jimwu6/Nocturne/RSGS/media/X 0.png

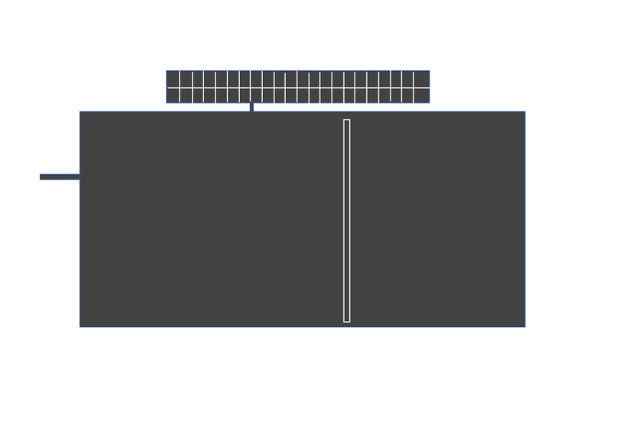
RSGS/media/X 0.png
