jimwu6/Nocturne/RSGS/media/X 5.png

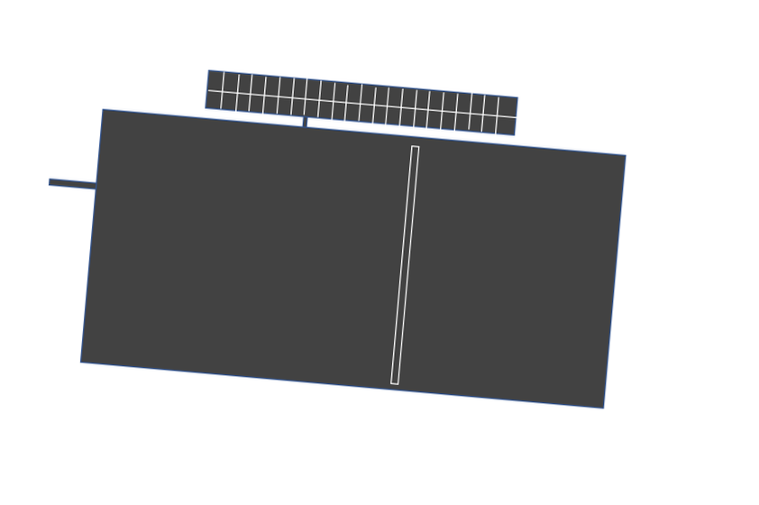
RSGS/media/X 5.png
