jimwu6/Nocturne/RSGS/media/X 20.png

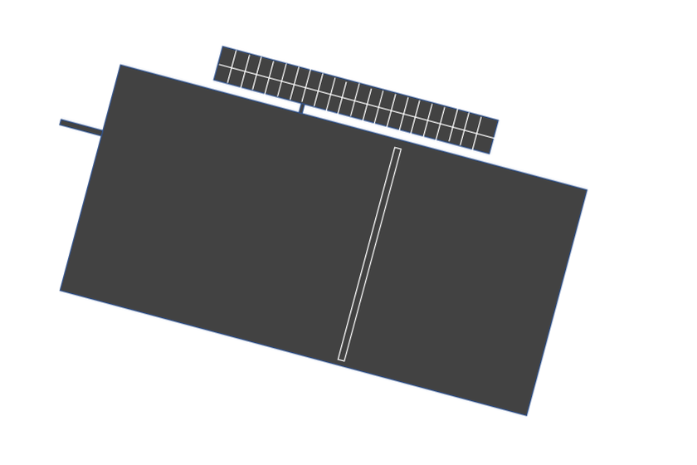
RSGS/media/X 20.png
