jimwu6/Nocturne/RSGS/media/X 25.png

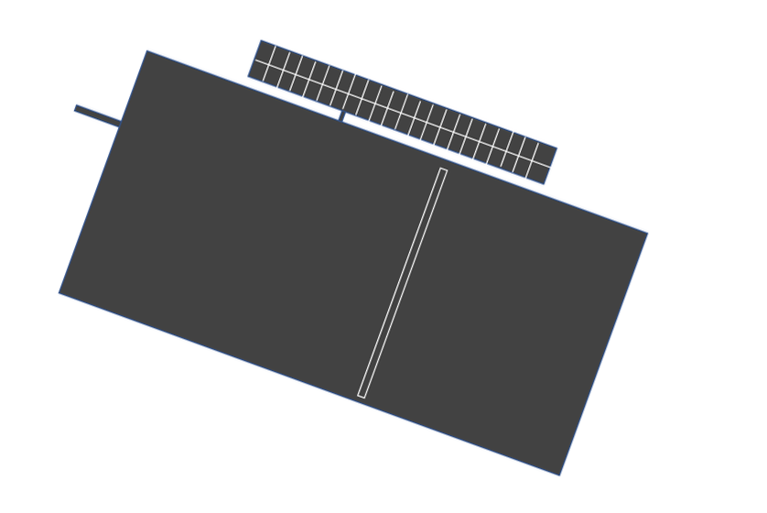
RSGS/media/X 25.png
