jimwu6/Nocturne/RSGS/media/X 35.png

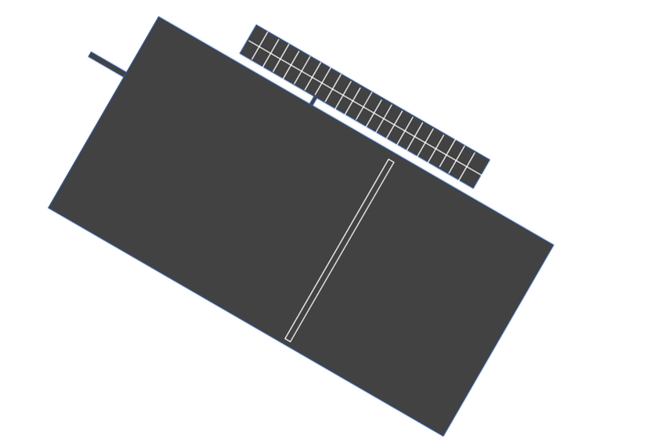
RSGS/media/X 35.png
