jimwu6/Nocturne/RSGS/media/X 50.png

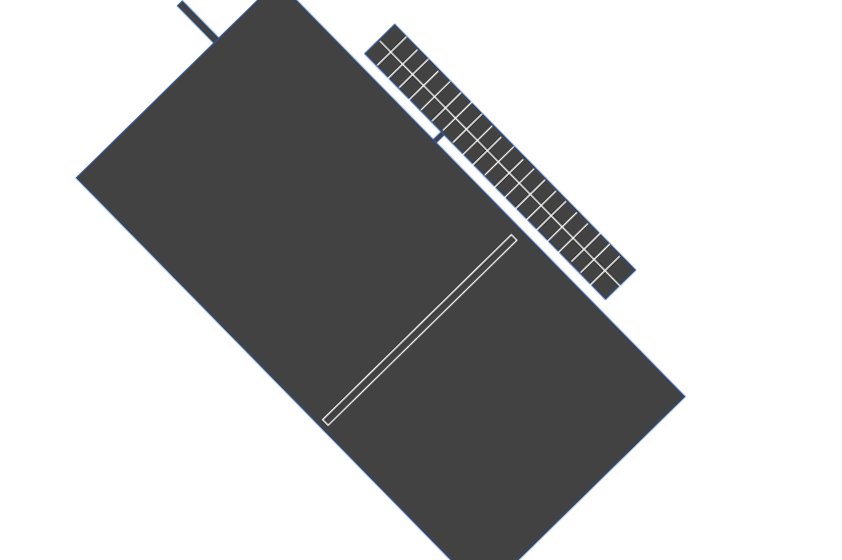
RSGS/media/X 50.png
