jimwu6/Nocturne/RSGS/media/X 60.png

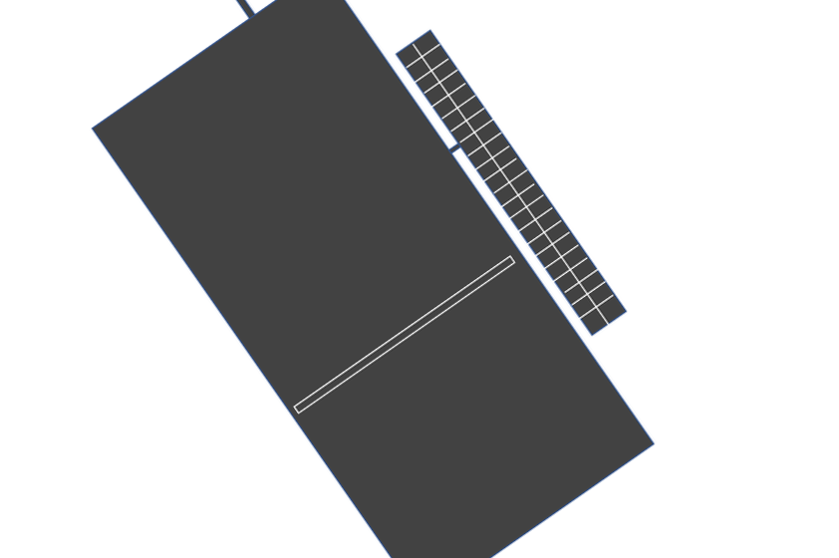
RSGS/media/X 60.png
