jimwu6/Nocturne/RSGS/media/X 80.png

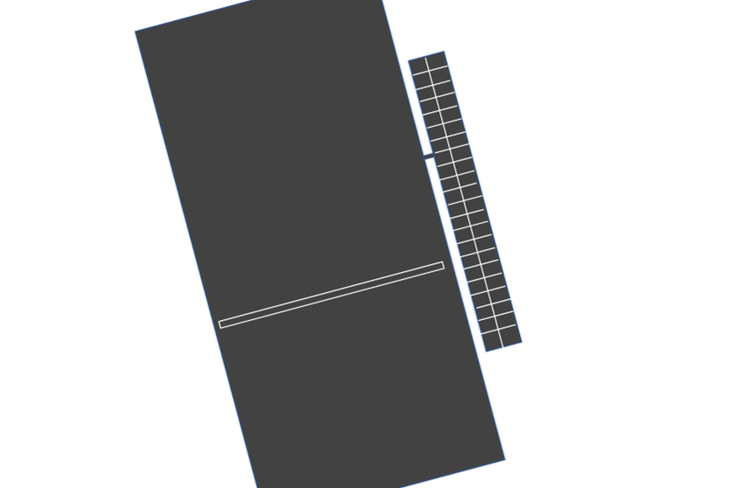
RSGS/media/X 80.png
