jimwu6/Nocturne/RSGS/media/X 85.png

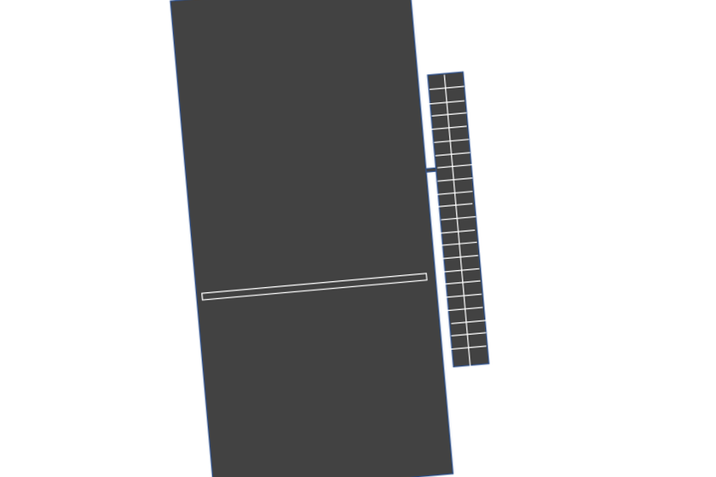
RSGS/media/X 85.png
