jimwu6/Nocturne/RSGS/media/X 95.png

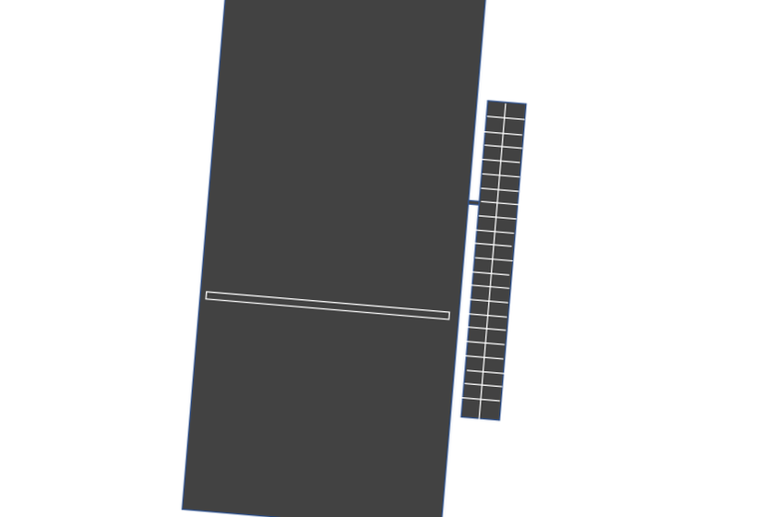
RSGS/media/X 95.png
