jimwu6/Nocturne/RSGS/media/X 105.png

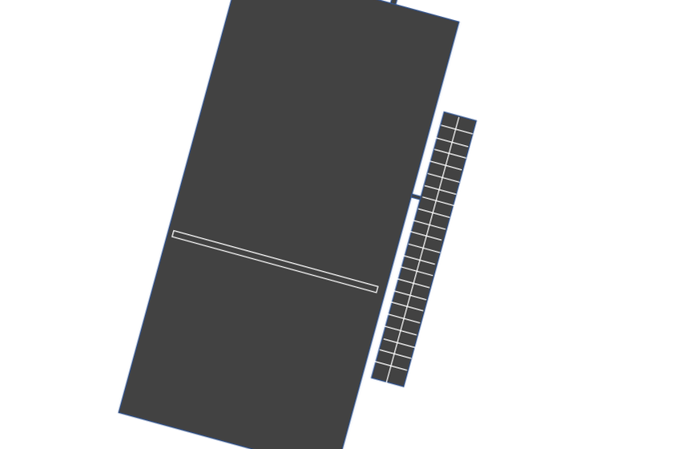
RSGS/media/X 105.png
