jimwu6/Nocturne/RSGS/media/X 110.png

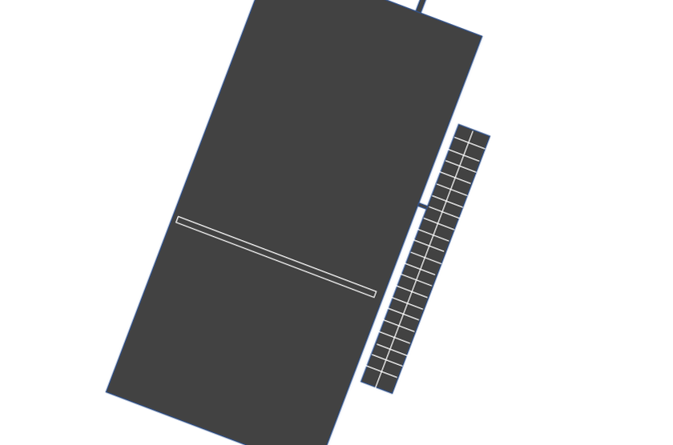
RSGS/media/X 110.png
