jimwu6/Nocturne/RSGS/media/X 130.png

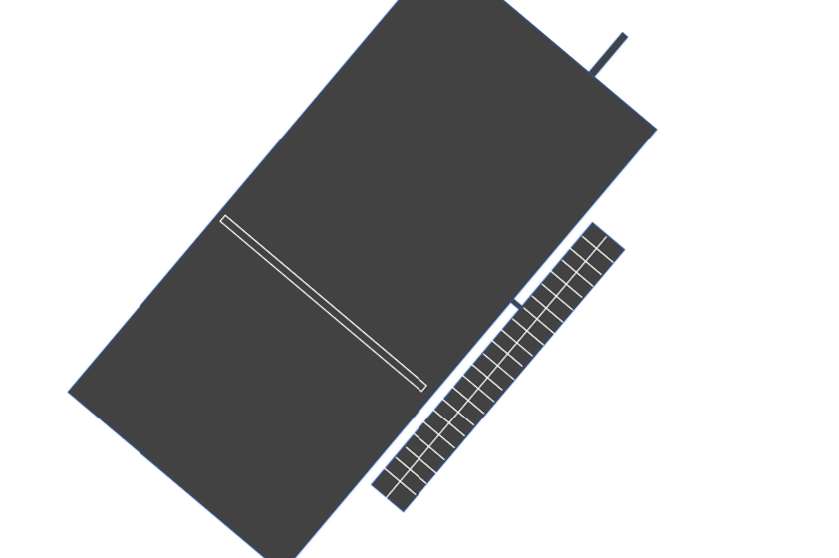
RSGS/media/X 130.png
