jimwu6/Nocturne/RSGS/media/X 140.png

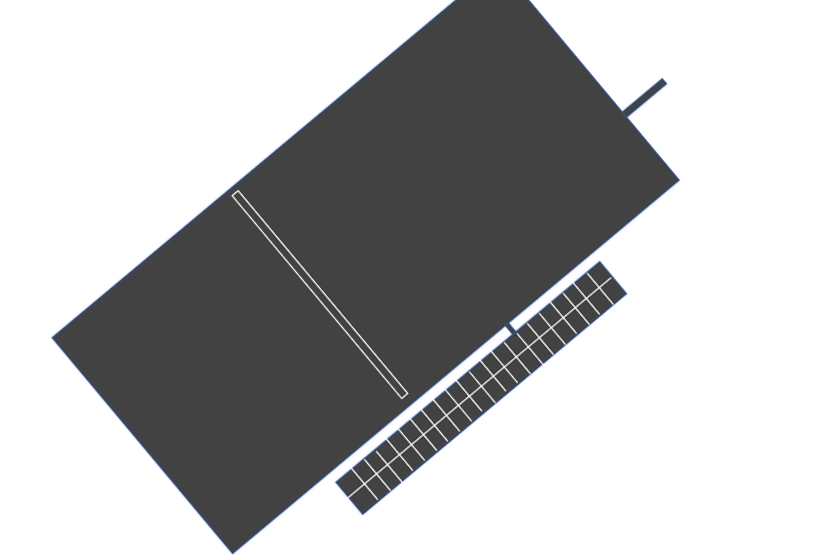
RSGS/media/X 140.png
