jimwu6/Nocturne/RSGS/media/X 145.png

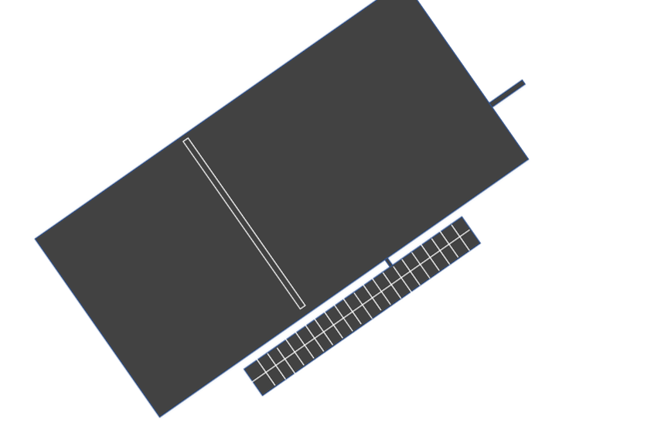
RSGS/media/X 145.png
