jimwu6/Nocturne/RSGS/media/X 155.png

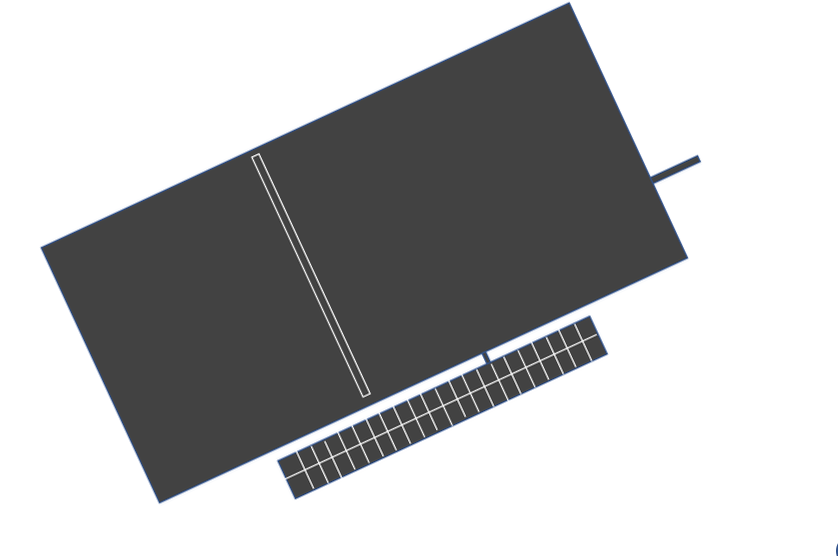
RSGS/media/X 155.png
