jimwu6/Nocturne/RSGS/media/X 160.png

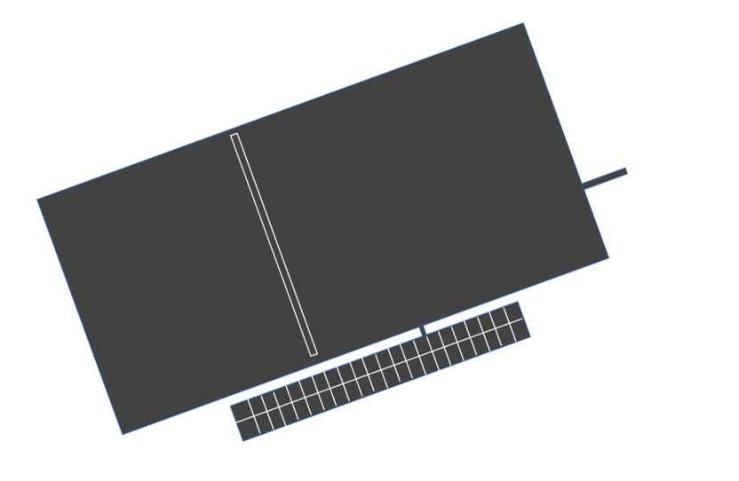
RSGS/media/X 160.png
