jimwu6/Nocturne/RSGS/media/X 170.png

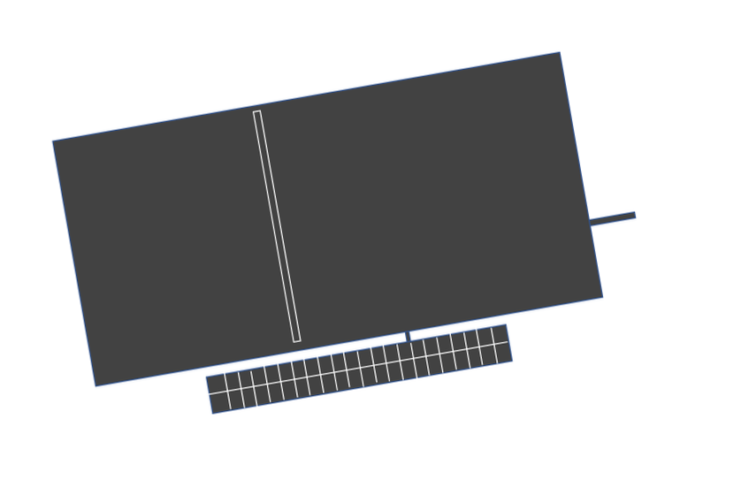
RSGS/media/X 170.png
