jimwu6/Nocturne/RSGS/media/X 175.png

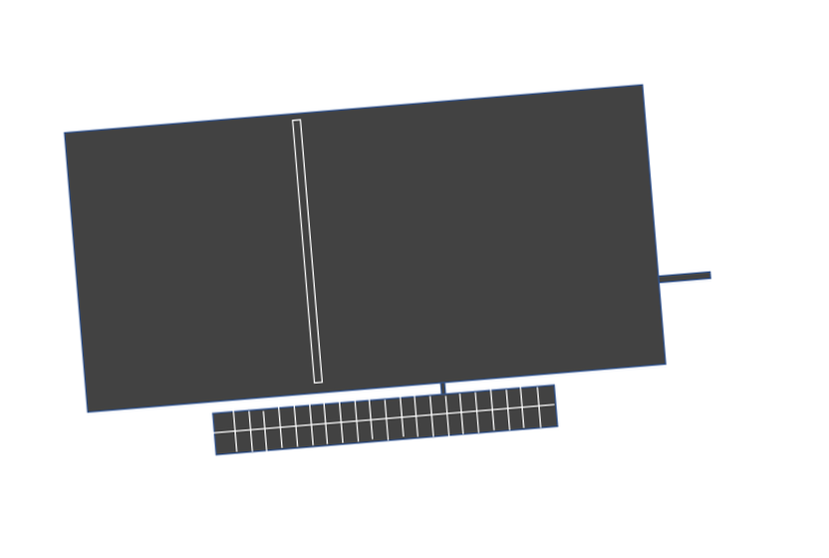
RSGS/media/X 175.png
