jimwu6/Nocturne/RSGS/media/X 180.png

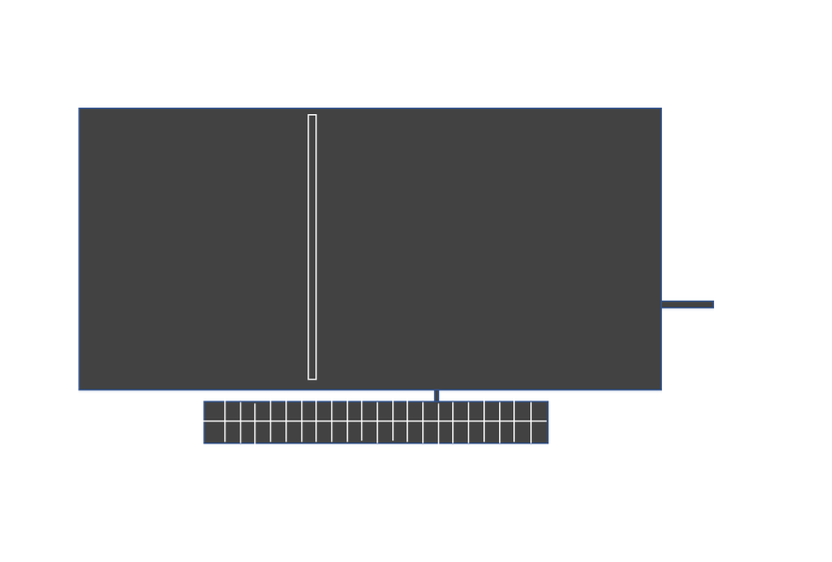
RSGS/media/X 180.png
