jimwu6/Nocturne/RSGS/media/X 185.png

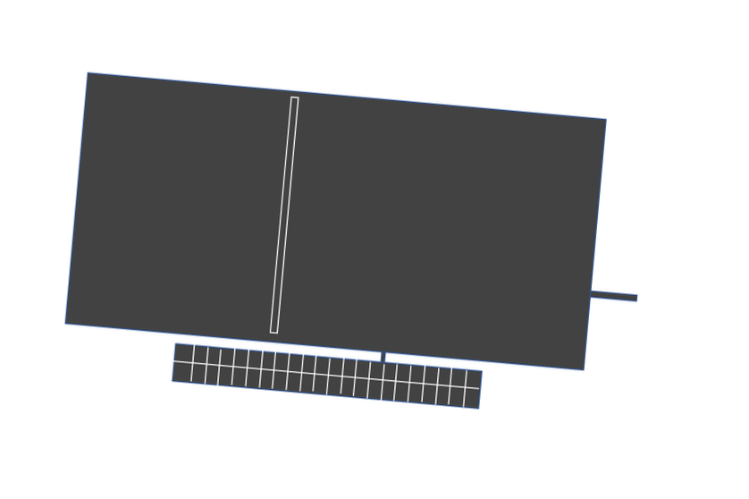
RSGS/media/X 185.png
