jimwu6/Nocturne/RSGS/media/X 190.png

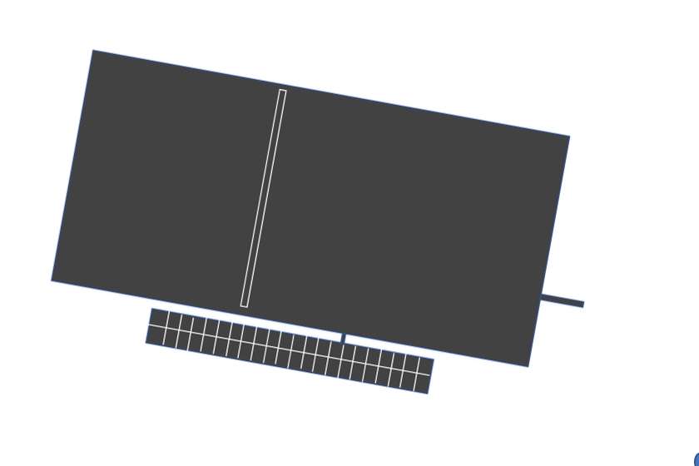
RSGS/media/X 190.png
