jimwu6/Nocturne/RSGS/media/X 195.png

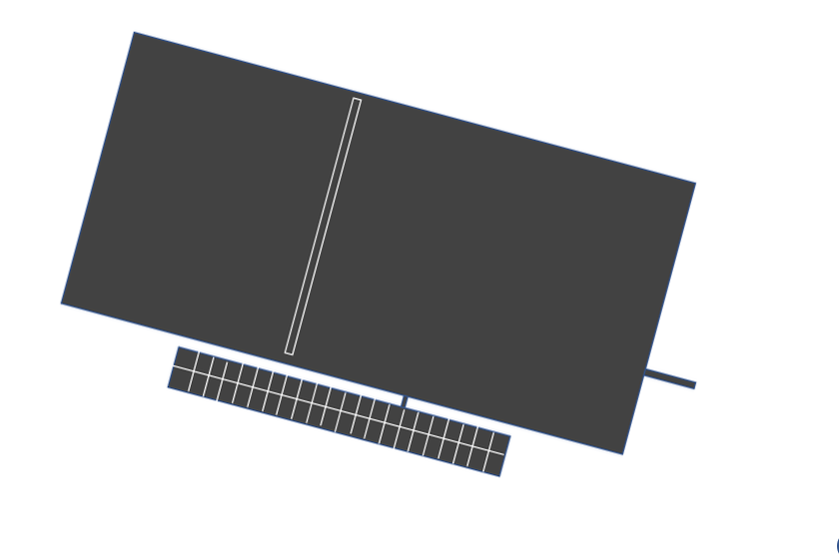
RSGS/media/X 195.png
