jimwu6/Nocturne/RSGS/media/X 205.png

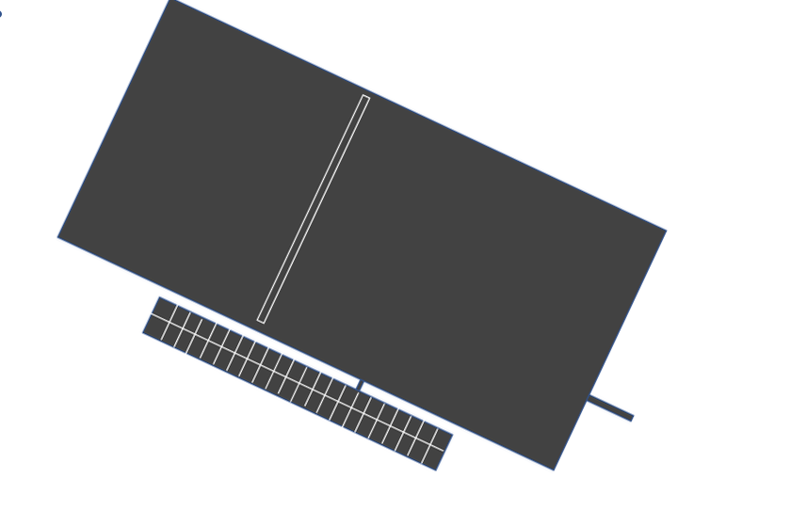
RSGS/media/X 205.png
