jimwu6/Nocturne/RSGS/media/X 215.png

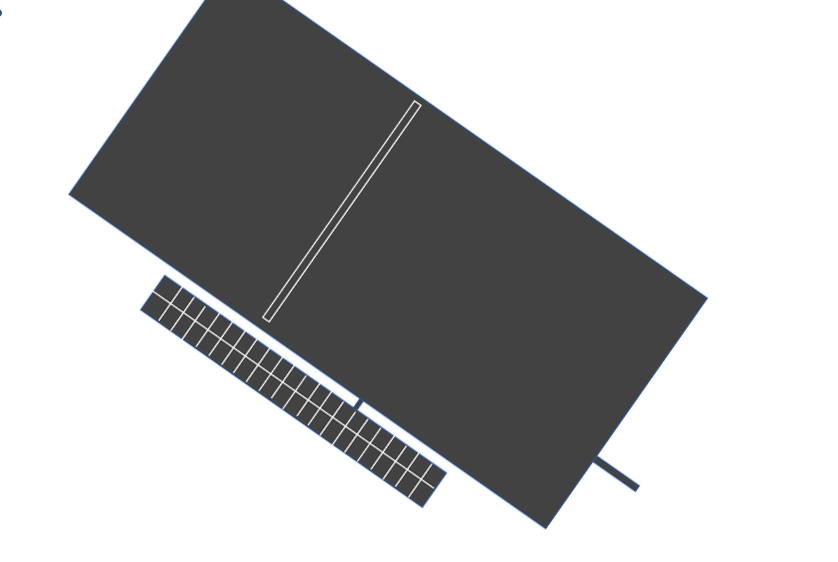
RSGS/media/X 215.png
