jimwu6/Nocturne/RSGS/media/X 220.png

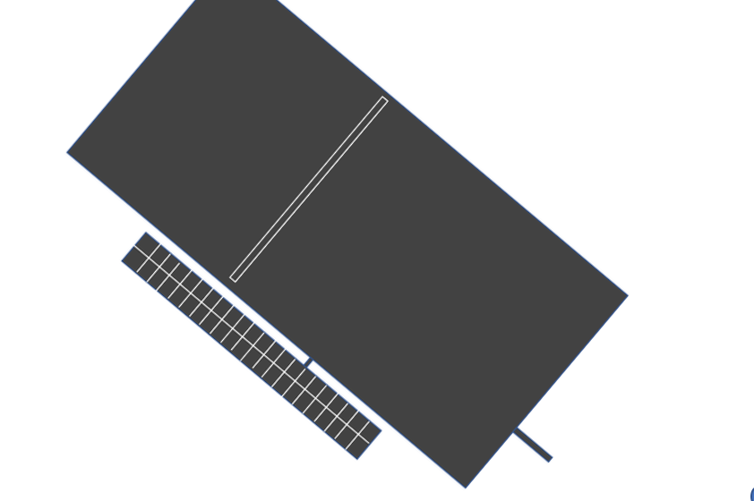
RSGS/media/X 220.png
