jimwu6/Nocturne/RSGS/media/X 235.png

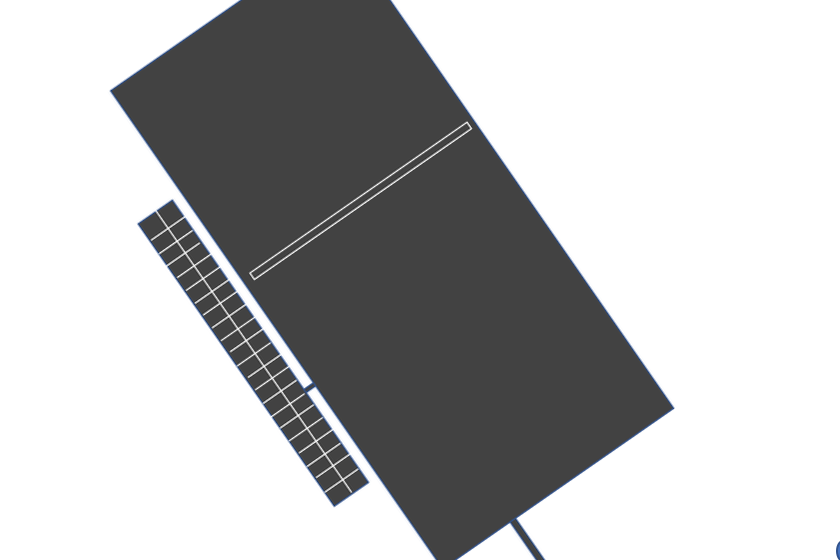
RSGS/media/X 235.png
