jimwu6/Nocturne/RSGS/media/X 250.png

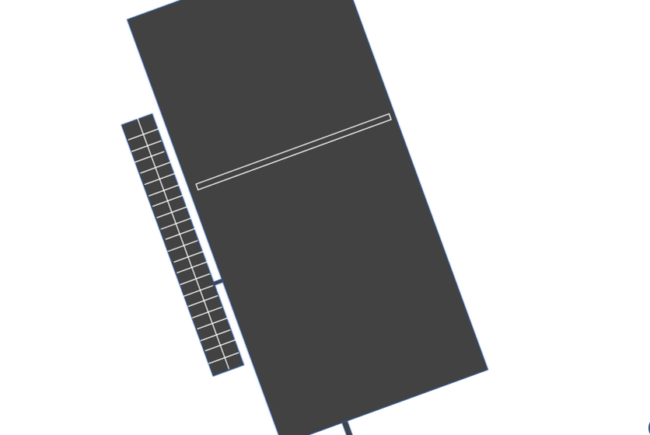
RSGS/media/X 250.png
