jimwu6/Nocturne/RSGS/media/X 265.png

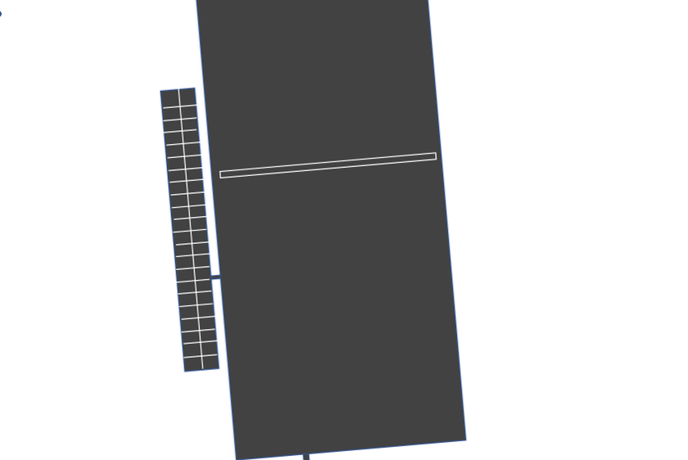
RSGS/media/X 265.png
