jimwu6/Nocturne/RSGS/media/X 270.png

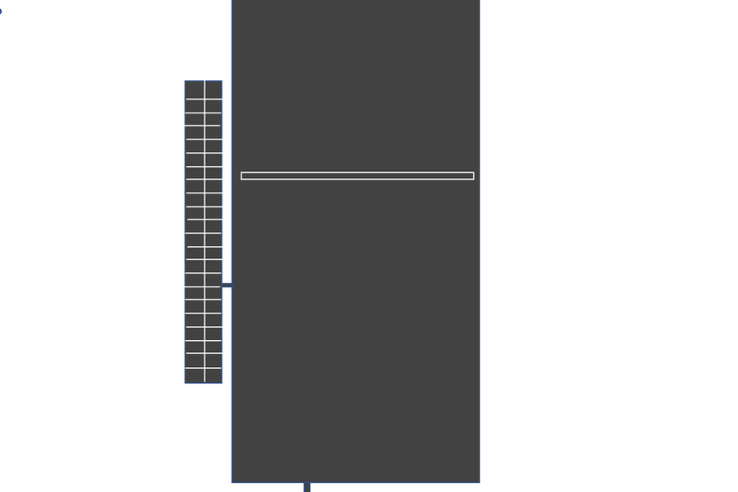
RSGS/media/X 270.png
