jimwu6/Nocturne/RSGS/media/X 275.png

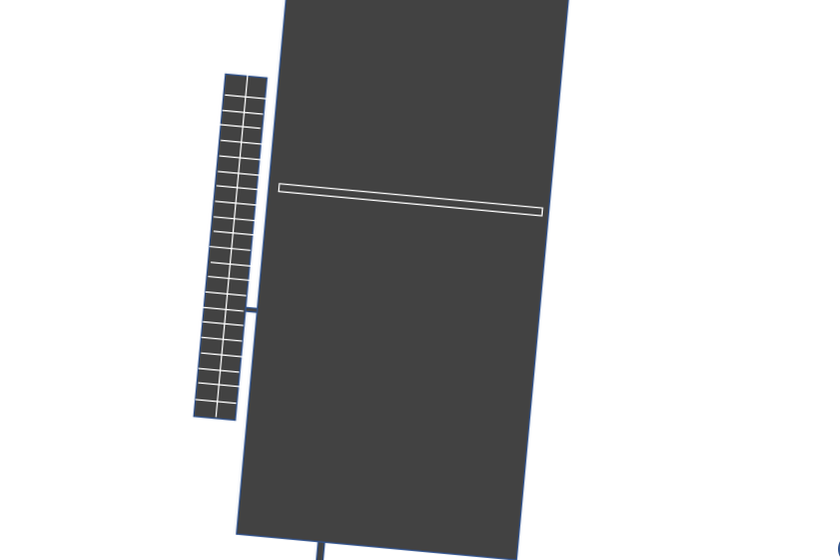
RSGS/media/X 275.png
