jimwu6/Nocturne/RSGS/media/X 280.png

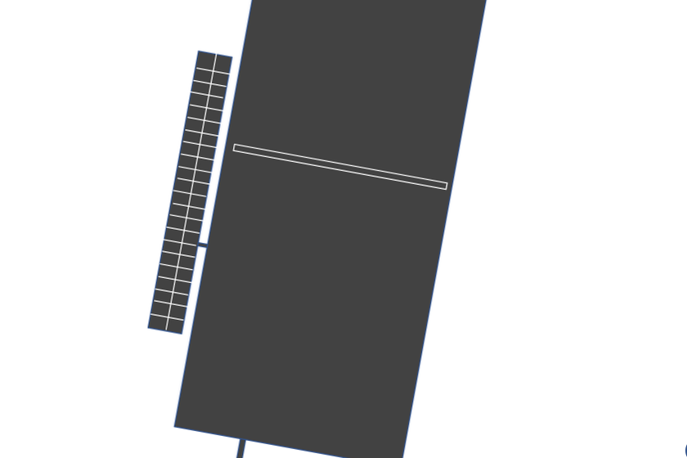
RSGS/media/X 280.png
