jimwu6/Nocturne/RSGS/media/X 295.png

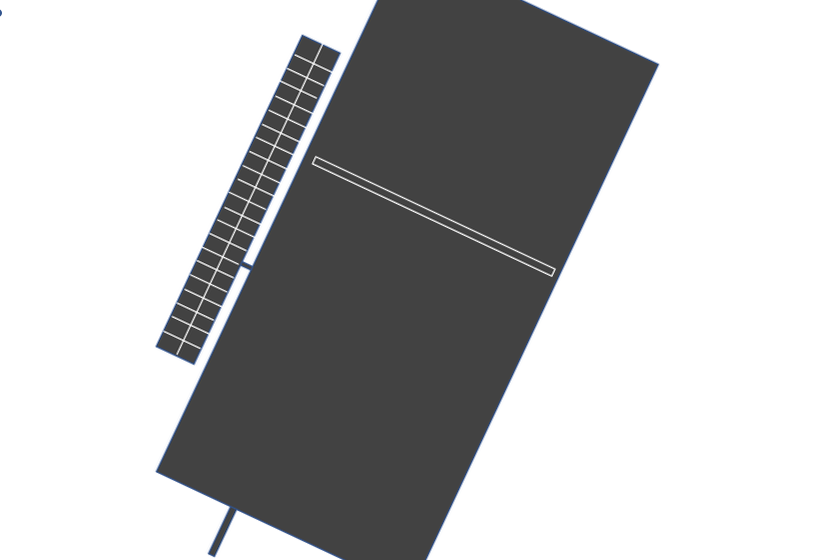
RSGS/media/X 295.png
