jimwu6/Nocturne/RSGS/media/X 300.png

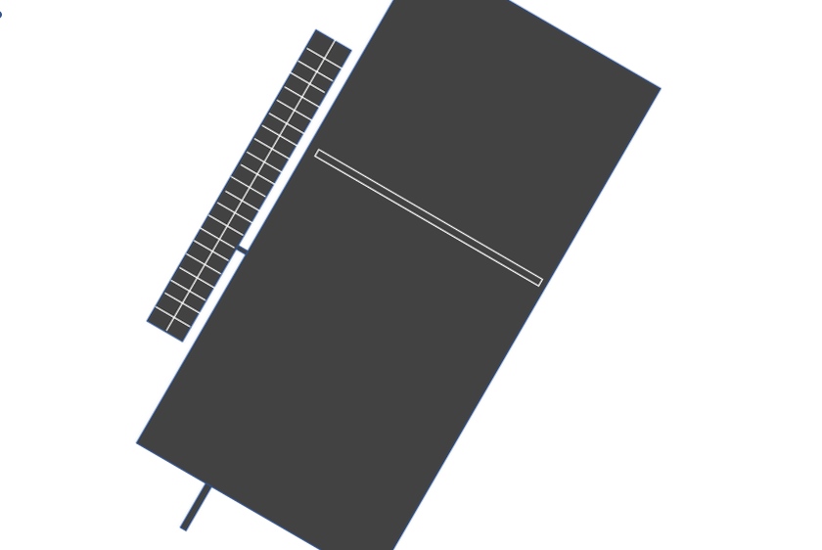
RSGS/media/X 300.png
