jimwu6/Nocturne/RSGS/media/X 315.png

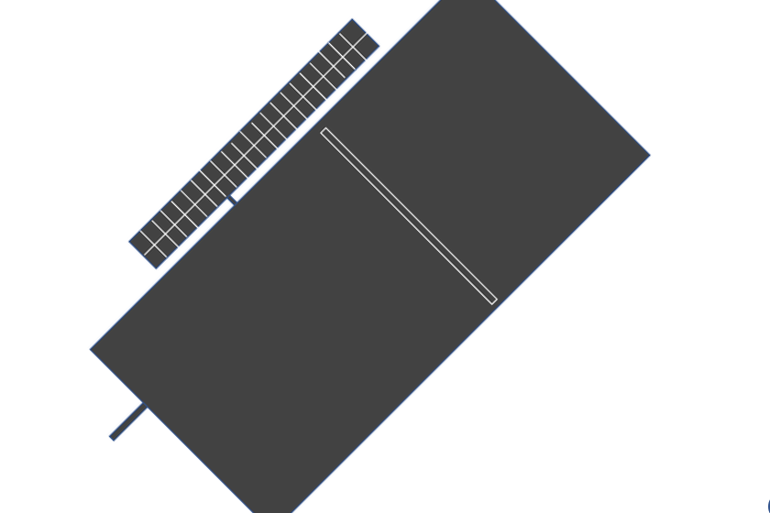
RSGS/media/X 315.png
