jimwu6/Nocturne/RSGS/media/X 325.png

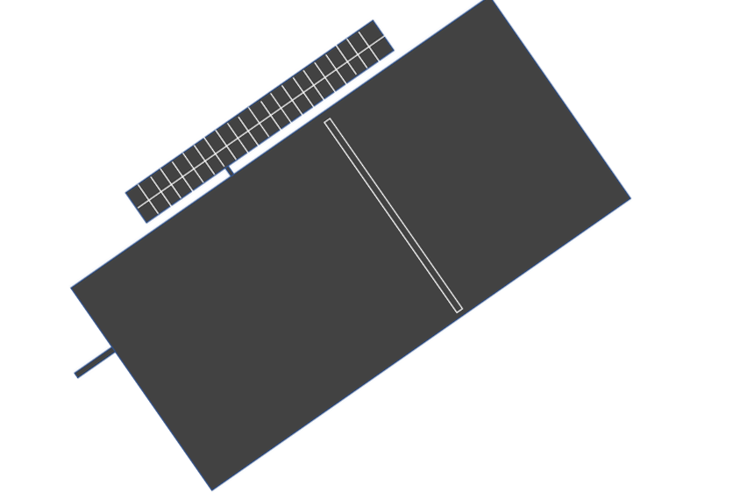
RSGS/media/X 325.png
