jimwu6/Nocturne/RSGS/media/X 335.png

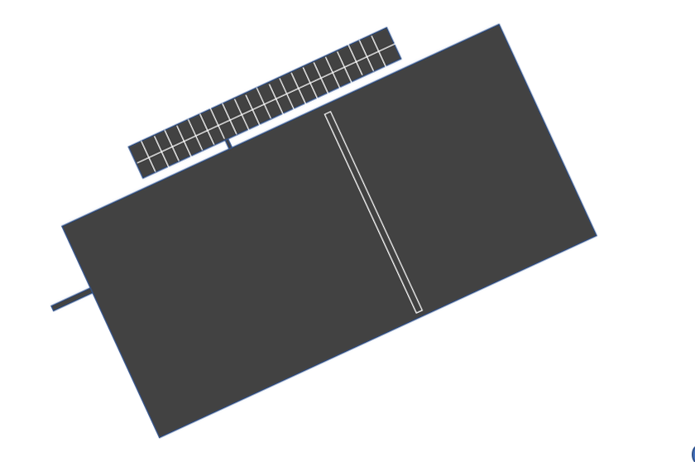
RSGS/media/X 335.png
