jimwu6/Nocturne/RSGS/media/X 345.png

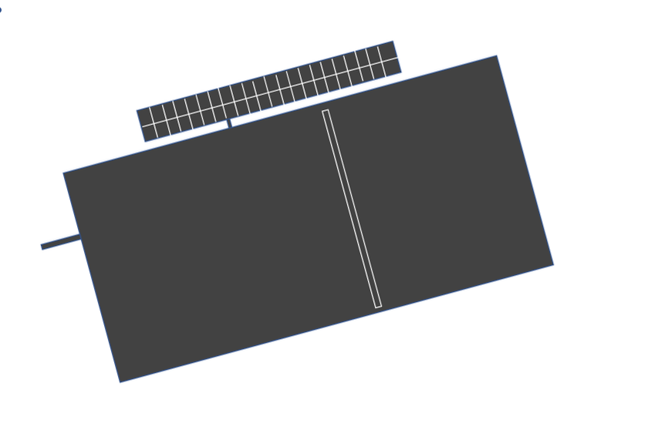
RSGS/media/X 345.png
