jimwu6/Nocturne/RSGS/media/X 355.png

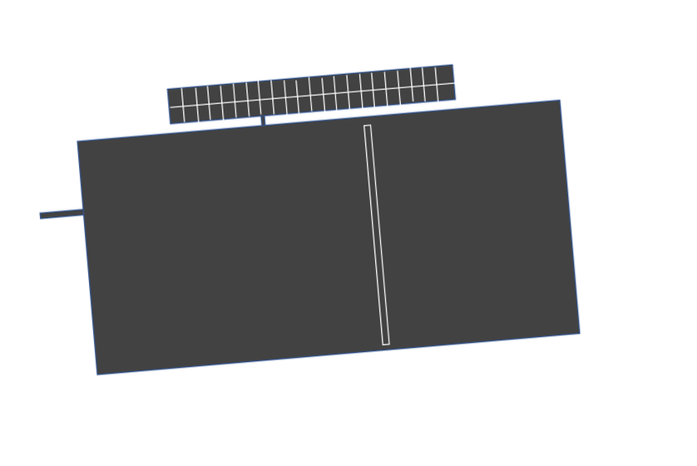
RSGS/media/X 355.png
