jimwu6/Nocturne/RSGS/media/Y 0.png

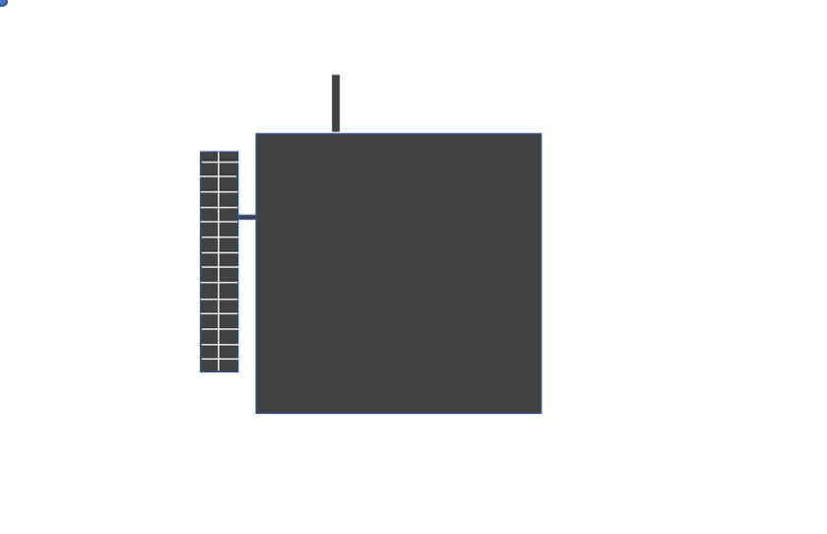
RSGS/media/Y 0.png
