jimwu6/Nocturne/RSGS/media/Y 10.png

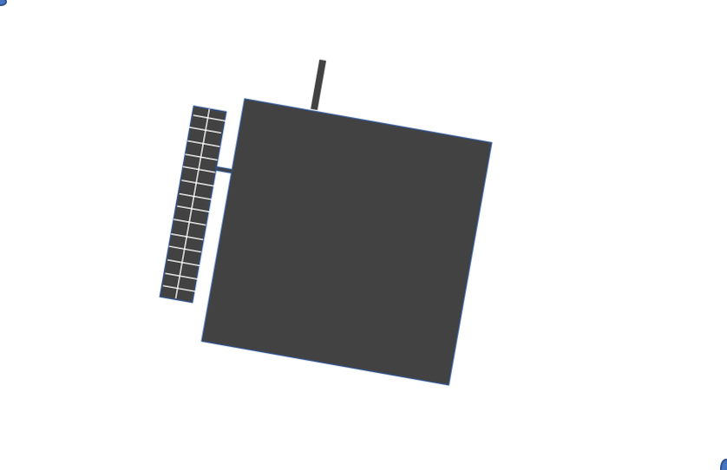
RSGS/media/Y 10.png
