jimwu6/Nocturne/RSGS/media/Y 30.png

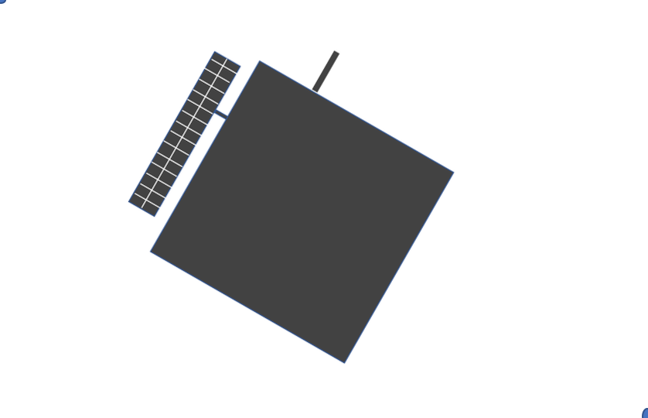
RSGS/media/Y 30.png
