jimwu6/Nocturne/RSGS/media/Y 40.png

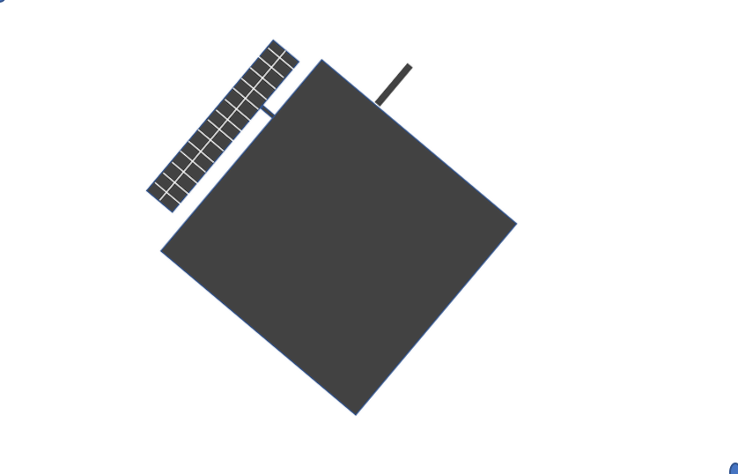
RSGS/media/Y 40.png
