jimwu6/Nocturne/RSGS/media/Y 60.png

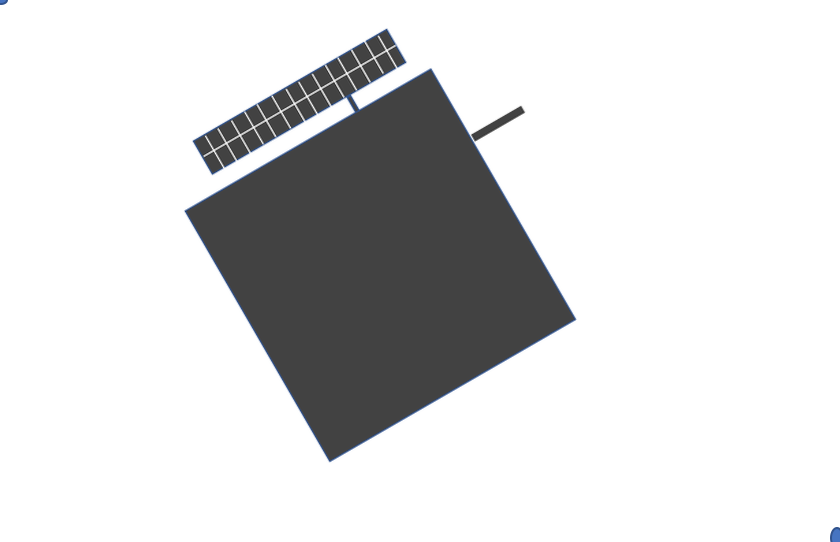
RSGS/media/Y 60.png
