jimwu6/Nocturne/RSGS/media/Y 80.png

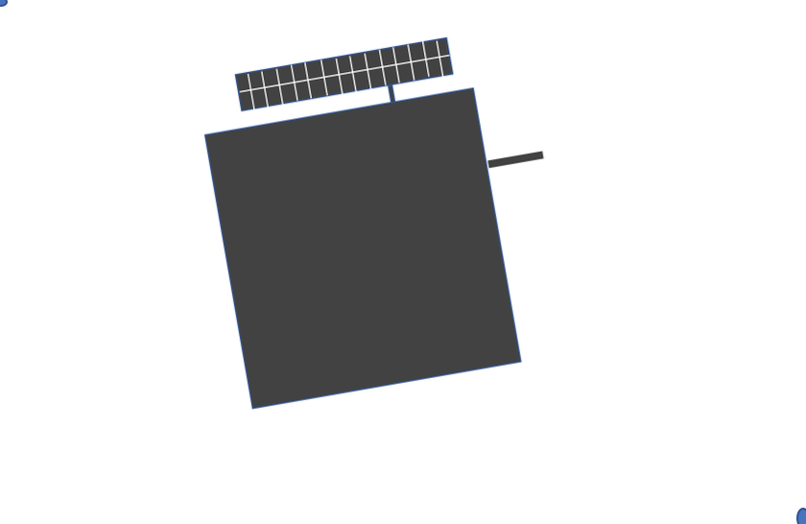
RSGS/media/Y 80.png
