jimwu6/Nocturne/RSGS/media/Y 100.png

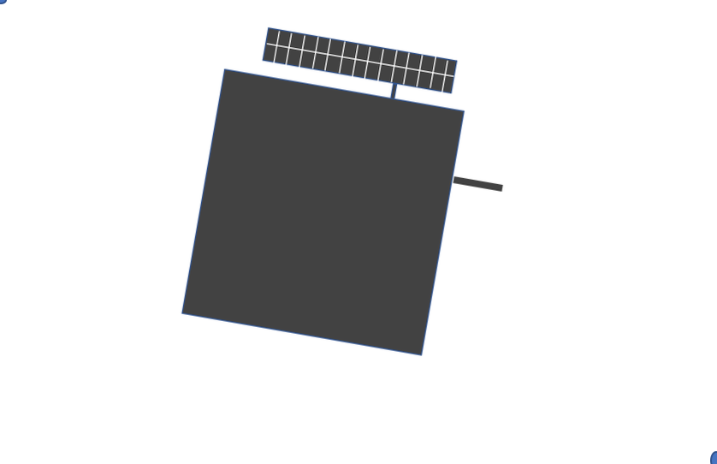
RSGS/media/Y 100.png
