jimwu6/Nocturne/RSGS/media/Y 120.png

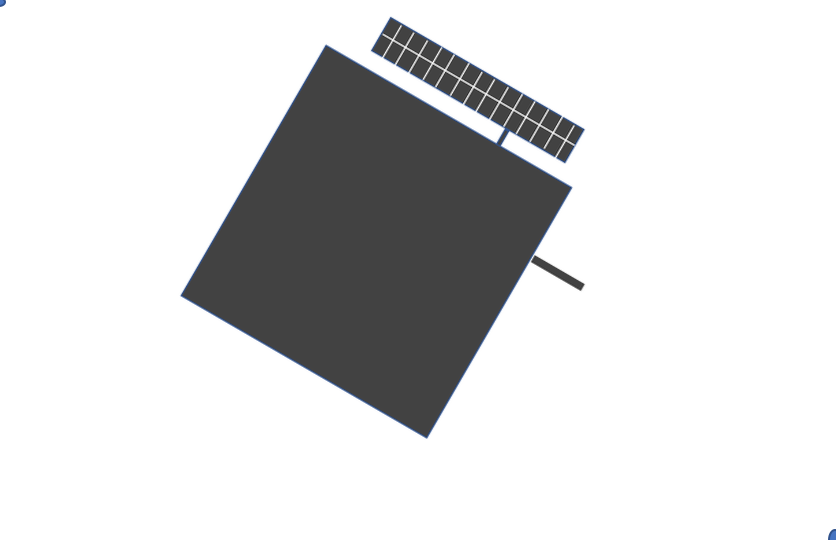
RSGS/media/Y 120.png
