jimwu6/Nocturne/RSGS/media/Y 140.png

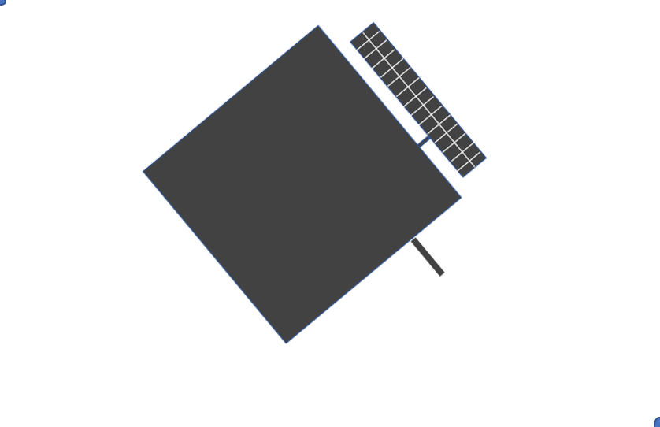
RSGS/media/Y 140.png
