jimwu6/Nocturne/RSGS/media/Y 170.png

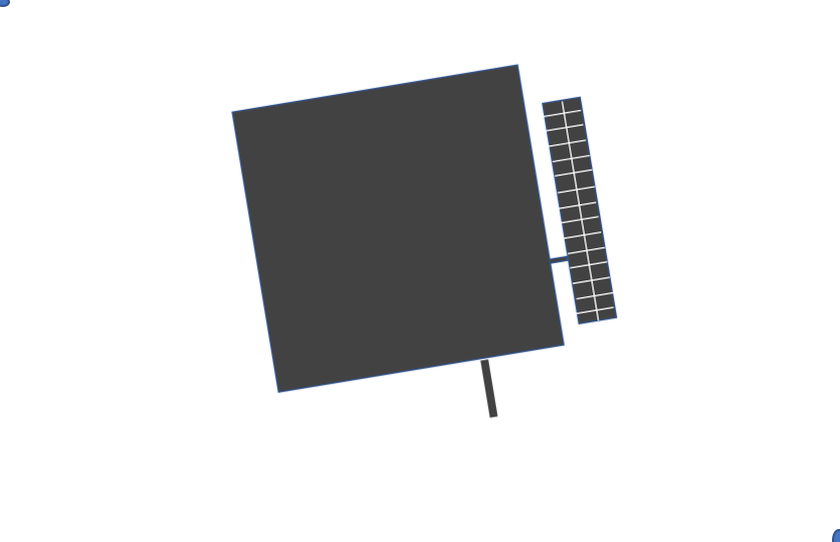
RSGS/media/Y 170.png
