jimwu6/Nocturne/RSGS/media/Y 190.png

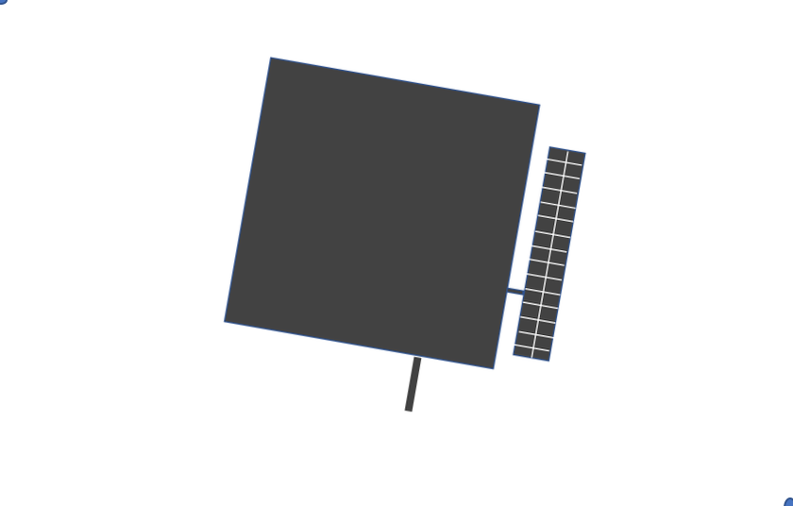
RSGS/media/Y 190.png
