jimwu6/Nocturne/RSGS/media/Y 200.png

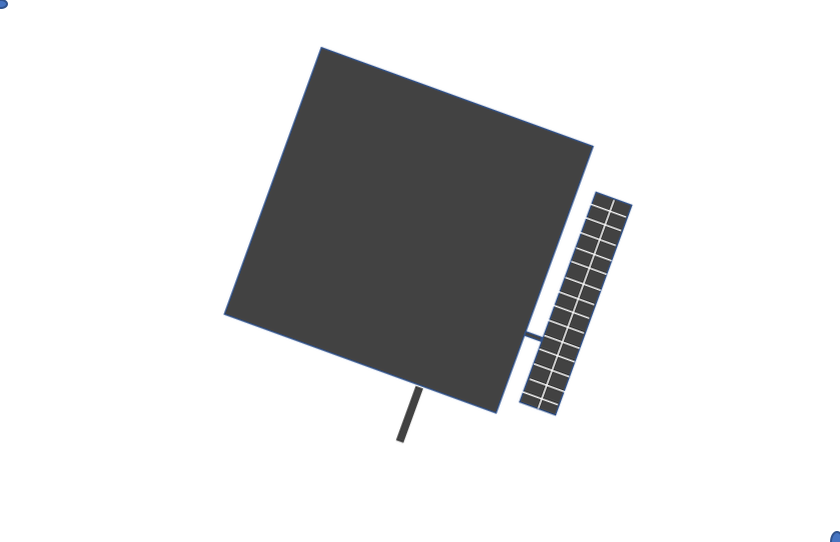
RSGS/media/Y 200.png
