jimwu6/Nocturne/RSGS/media/Y 210.png

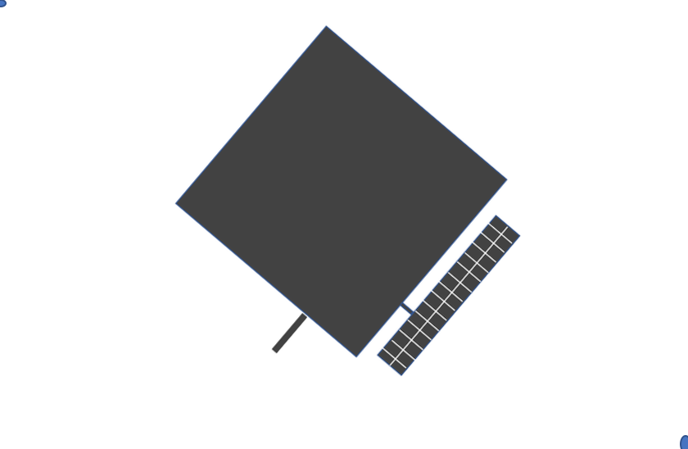
RSGS/media/Y 210.png
