jimwu6/Nocturne/RSGS/media/Y 250.png

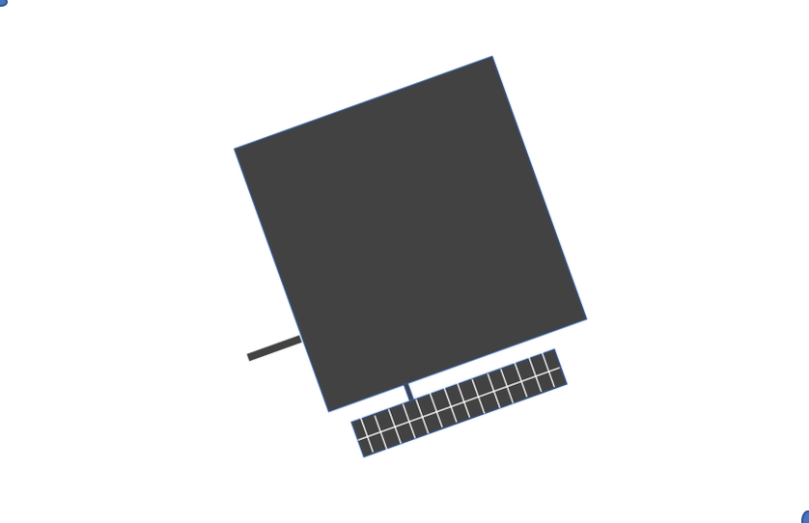
RSGS/media/Y 250.png
