jimwu6/Nocturne/RSGS/media/Y 270.png

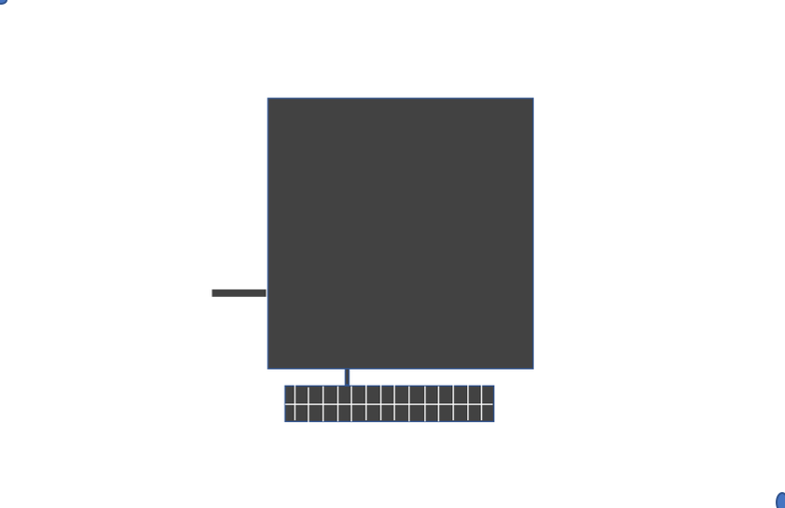
RSGS/media/Y 270.png
