jimwu6/Nocturne/RSGS/media/Y 290.png

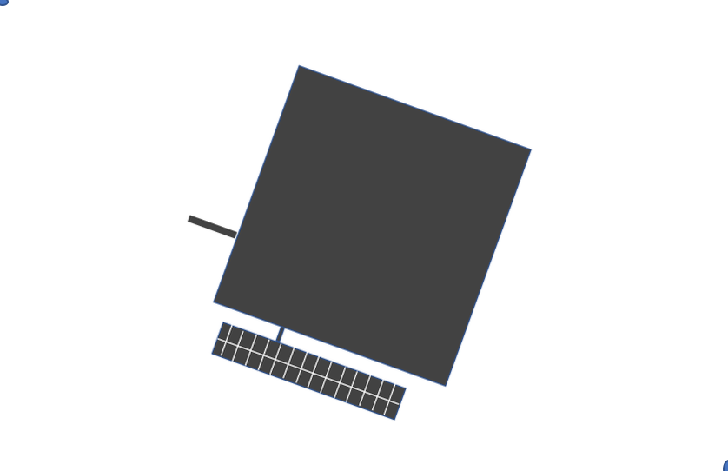
RSGS/media/Y 290.png
