jimwu6/Nocturne/RSGS/media/Y 320.png

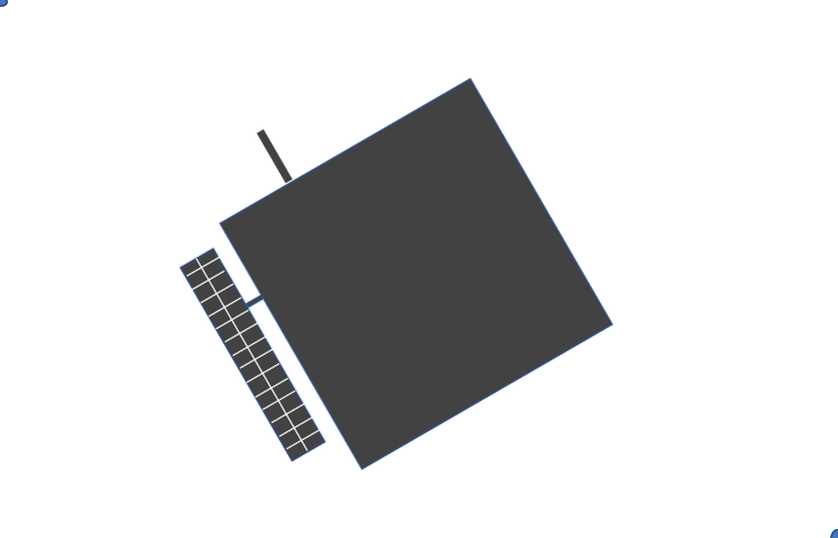
RSGS/media/Y 320.png
