jimwu6/Nocturne/RSGS/media/Z 0.png

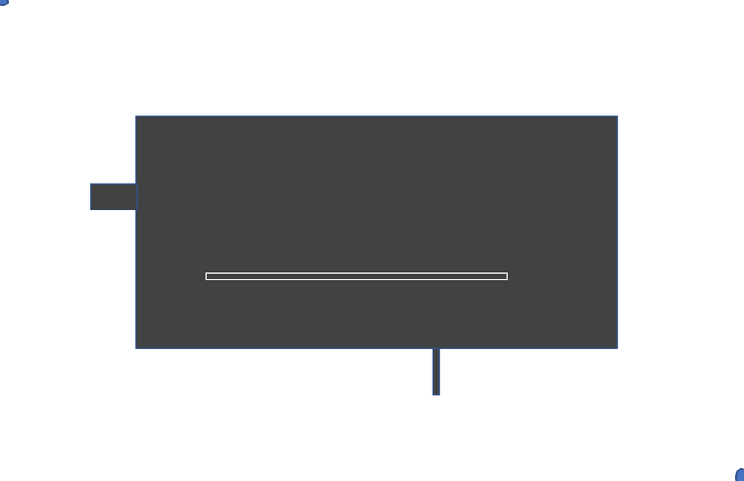
RSGS/media/Z 0.png
