jimwu6/Nocturne/RSGS/media/Z 10.png

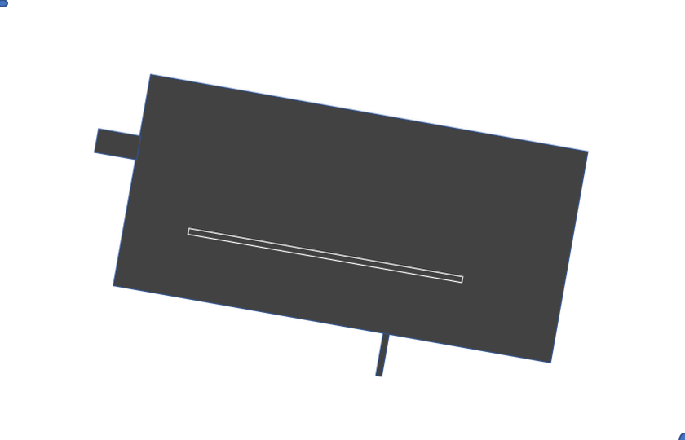
RSGS/media/Z 10.png
