jimwu6/Nocturne/RSGS/media/Z 20.png

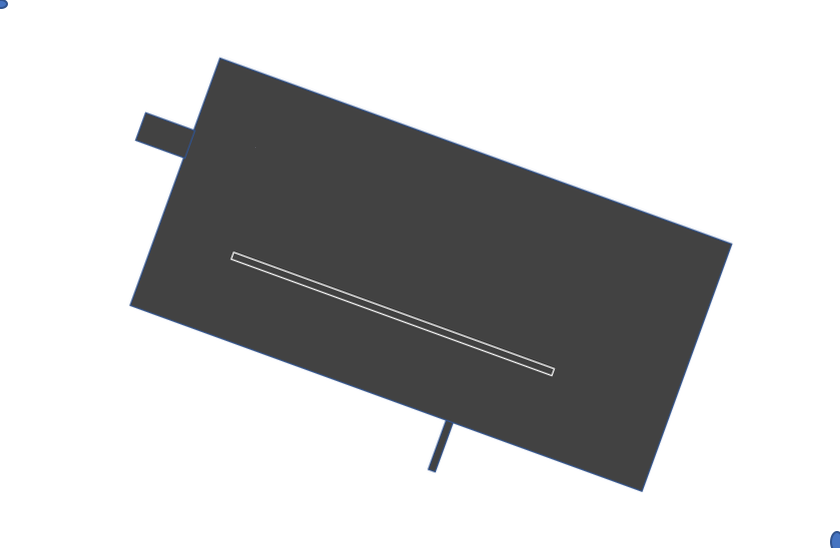
RSGS/media/Z 20.png
