jimwu6/Nocturne/RSGS/media/Z 30.png

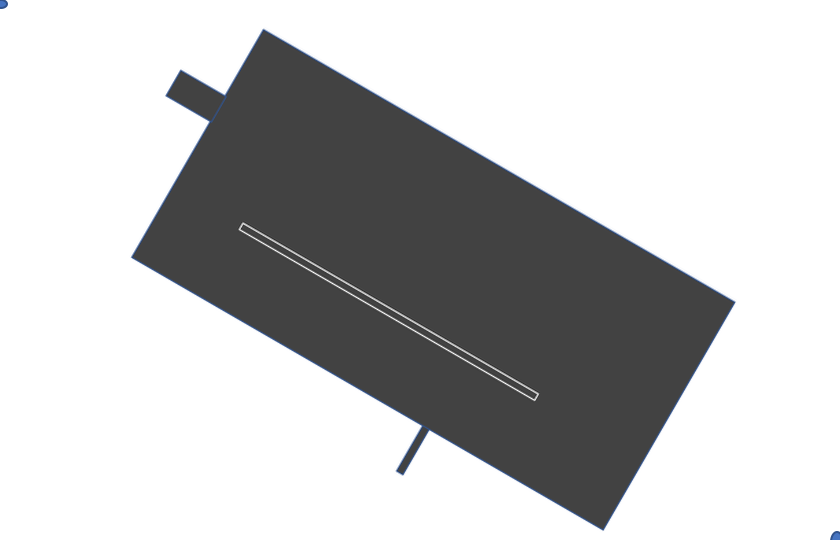
RSGS/media/Z 30.png
