jimwu6/Nocturne/RSGS/media/Z 40.png

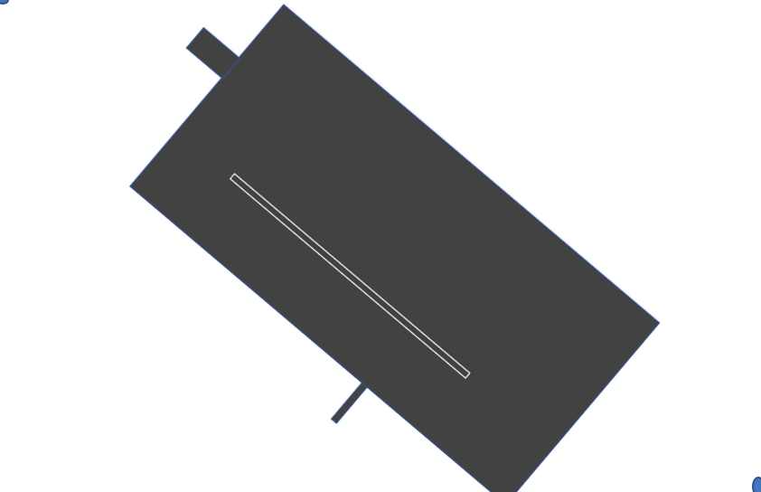
RSGS/media/Z 40.png
