jimwu6/Nocturne/RSGS/media/Z 60.png

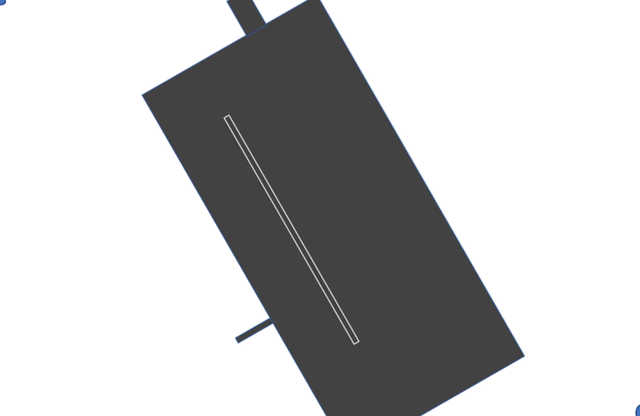
RSGS/media/Z 60.png
