jimwu6/Nocturne/RSGS/media/Z 70.png

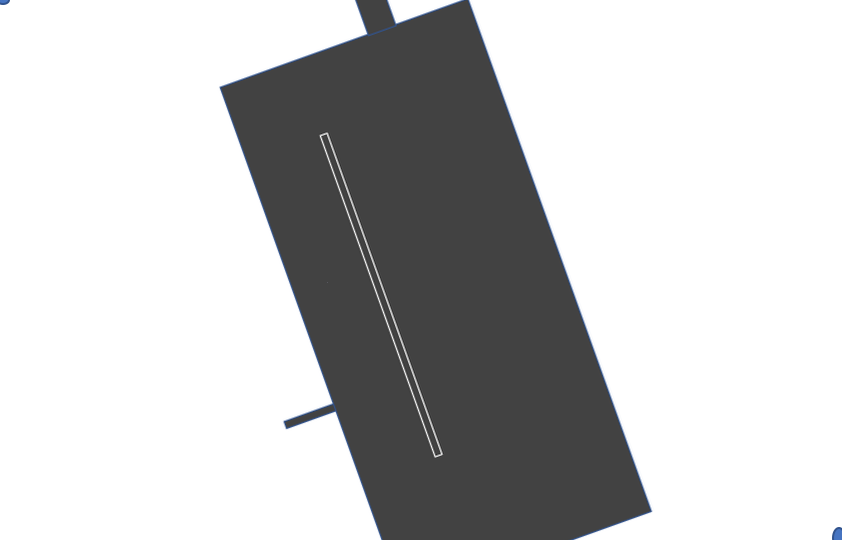
RSGS/media/Z 70.png
