jimwu6/Nocturne/RSGS/media/Z 100.png

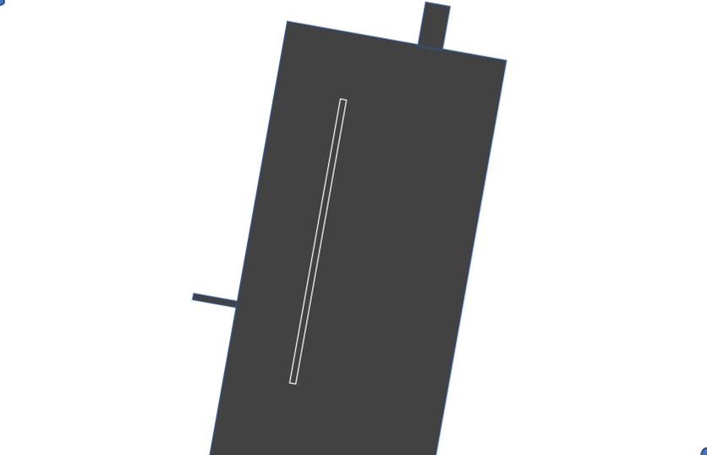
RSGS/media/Z 100.png
