jimwu6/Nocturne/RSGS/media/Z 130.png

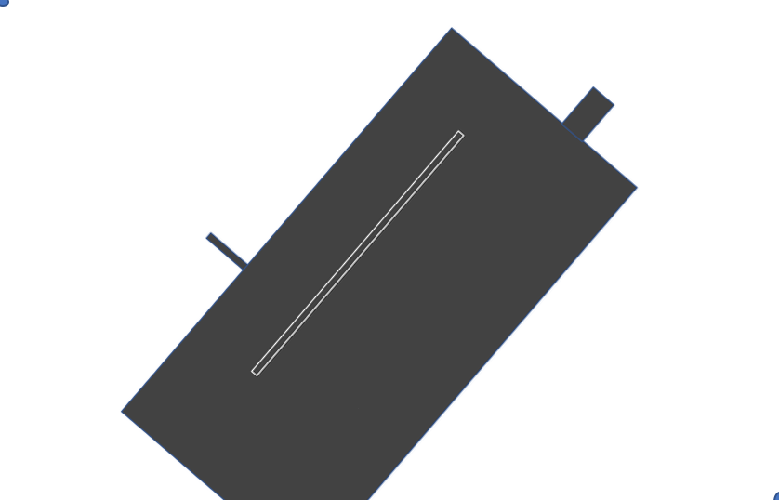
RSGS/media/Z 130.png
