jimwu6/Nocturne/RSGS/media/Z 150.png

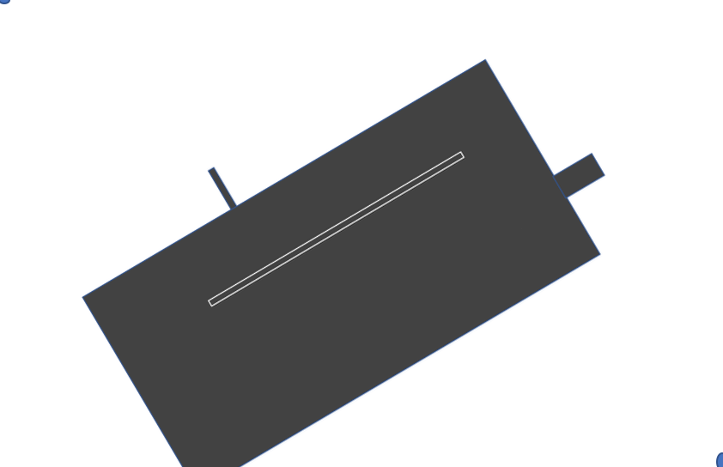
RSGS/media/Z 150.png
