jimwu6/Nocturne/RSGS/media/Z 160.png

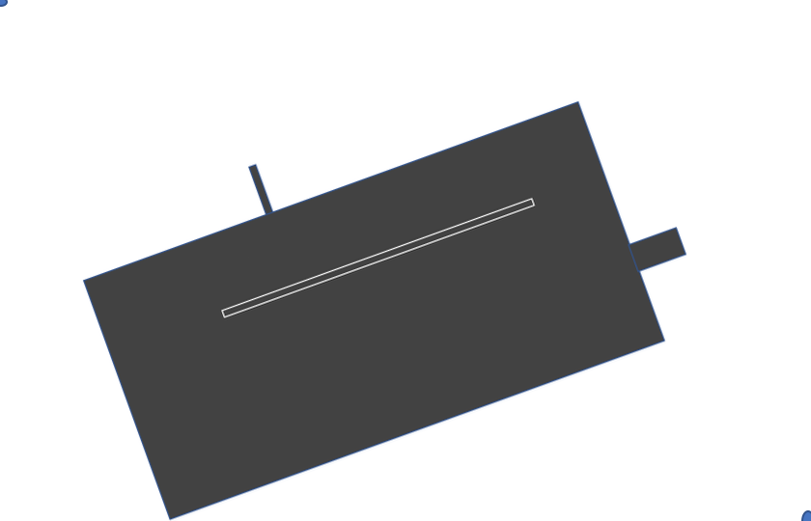
RSGS/media/Z 160.png
