jimwu6/Nocturne/RSGS/media/Z 170.png

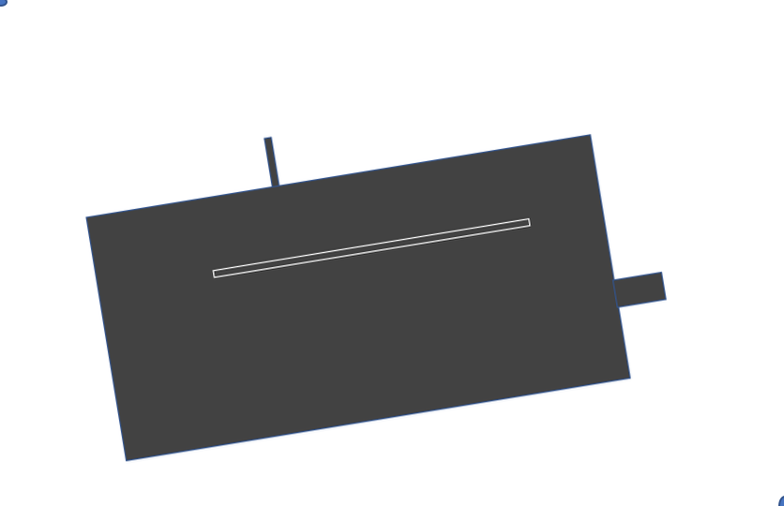
RSGS/media/Z 170.png
