jimwu6/Nocturne/RSGS/media/Z 180.png

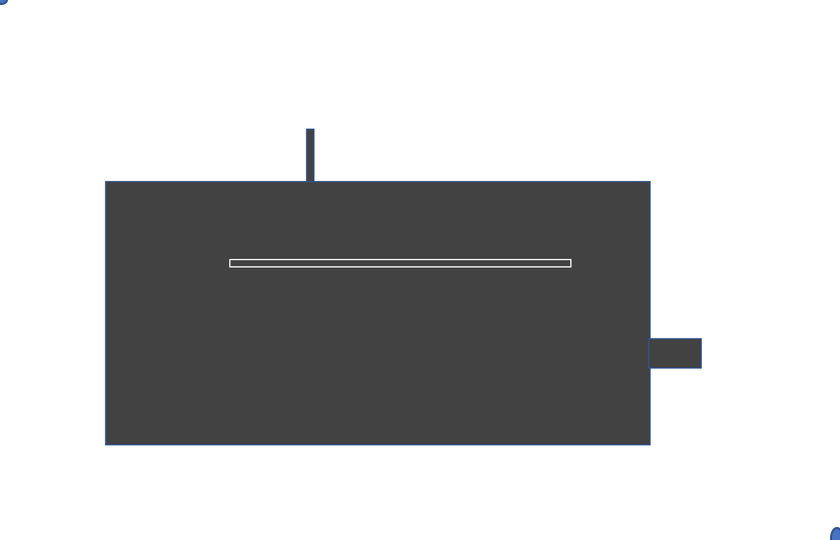
RSGS/media/Z 180.png
