jimwu6/Nocturne/RSGS/media/Z 190.png

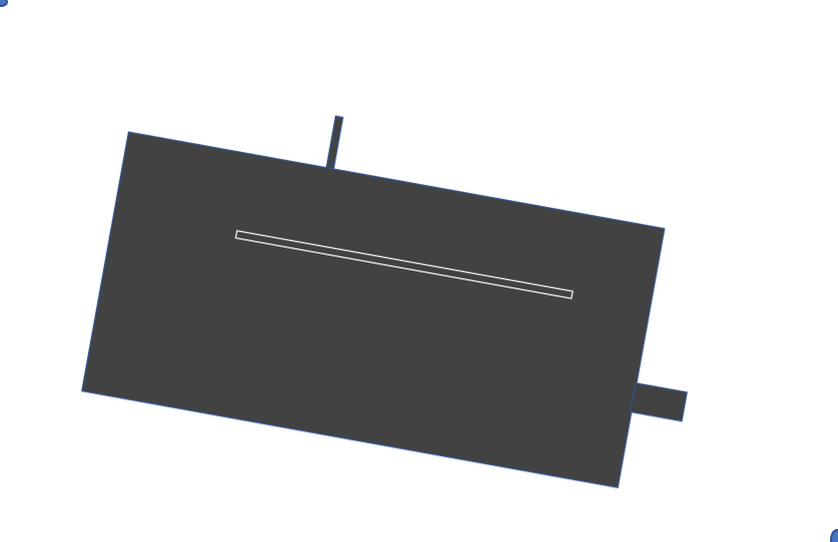
RSGS/media/Z 190.png
