jimwu6/Nocturne/RSGS/media/Z 200.png

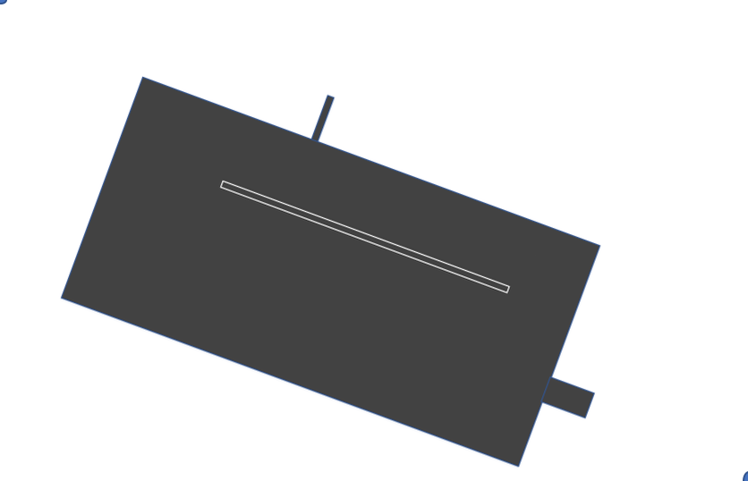
RSGS/media/Z 200.png
