jimwu6/Nocturne/RSGS/media/Z 210.png

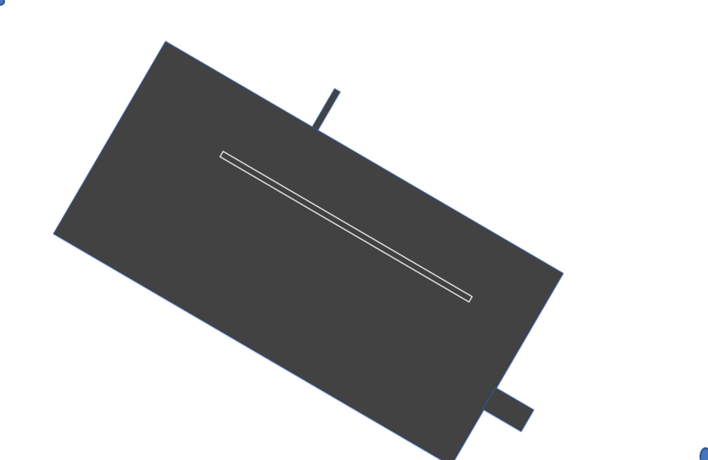
RSGS/media/Z 210.png
