jimwu6/Nocturne/RSGS/media/Z 220.png

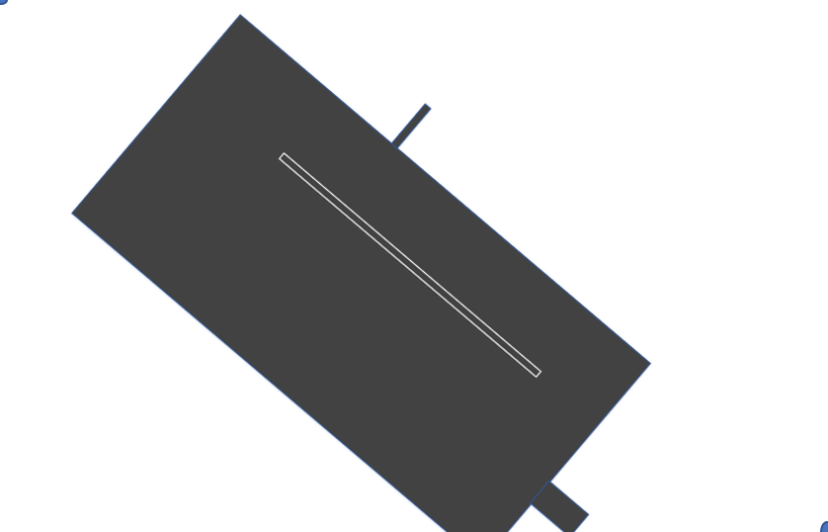
RSGS/media/Z 220.png
