jimwu6/Nocturne/RSGS/media/Z 240.png

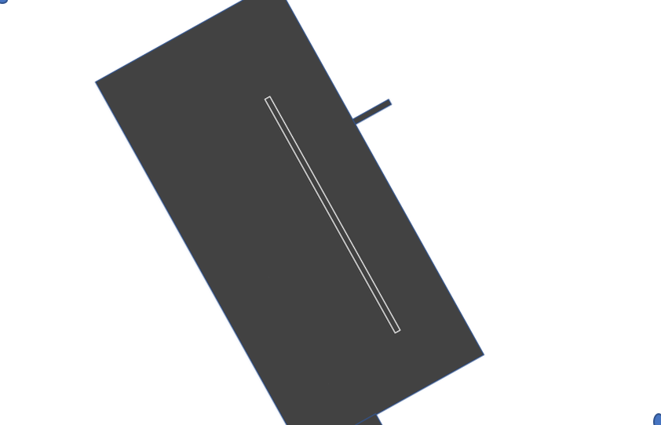
RSGS/media/Z 240.png
