jimwu6/Nocturne/RSGS/media/Z 250.png

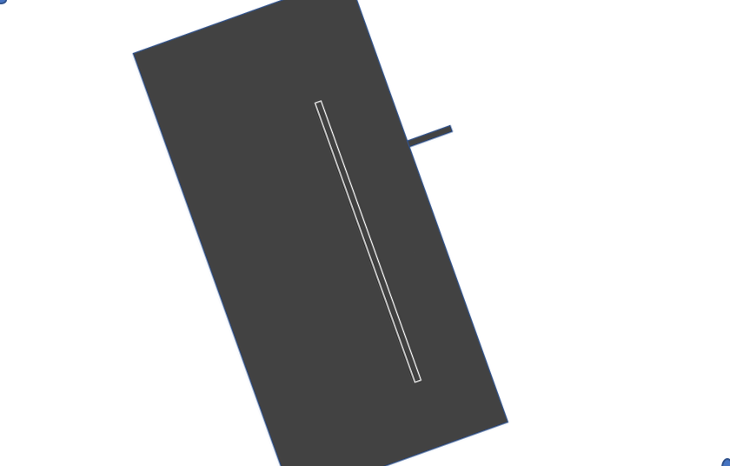
RSGS/media/Z 250.png
