jimwu6/Nocturne/RSGS/media/Z 260.png

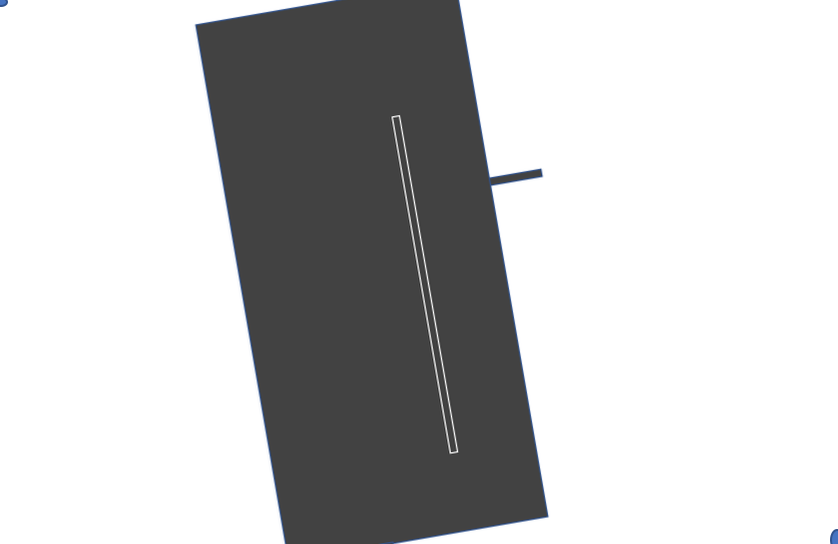
RSGS/media/Z 260.png
