jimwu6/Nocturne/RSGS/media/Z 290.png

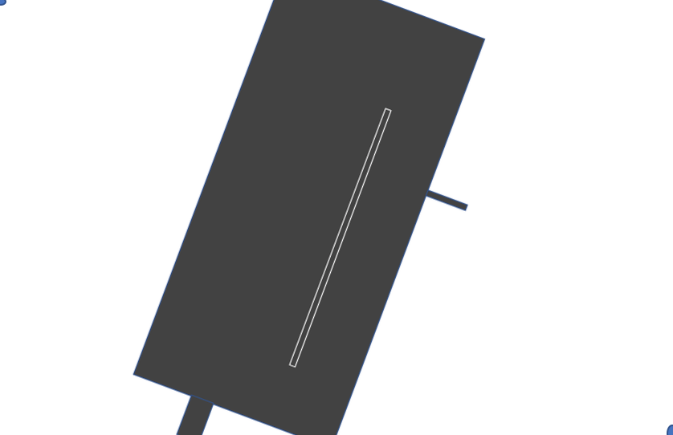
RSGS/media/Z 290.png
