jimwu6/Nocturne/RSGS/media/Z 300.png

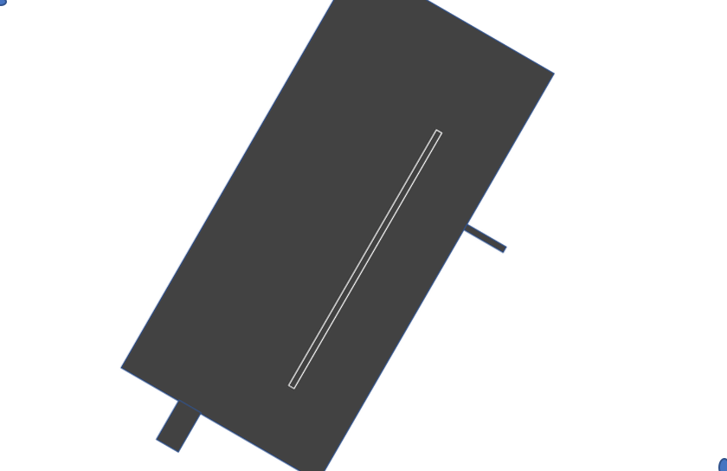
RSGS/media/Z 300.png
