jimwu6/Nocturne/RSGS/media/Z 320.png

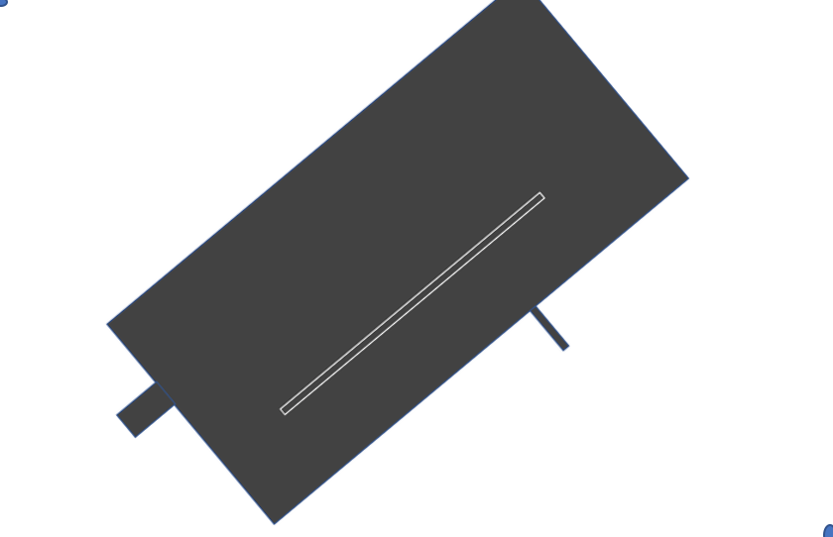
RSGS/media/Z 320.png
