jimwu6/Nocturne/RSGS/media/Z 330.png

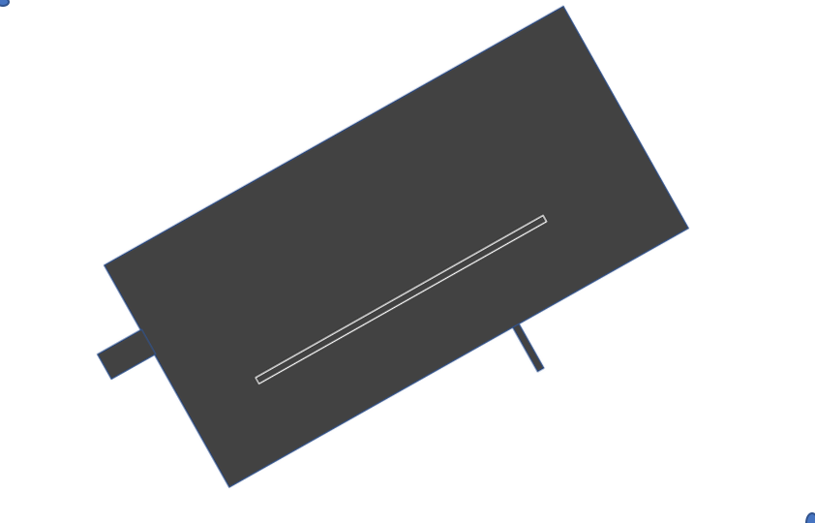
RSGS/media/Z 330.png
