jimwu6/Nocturne/RSGS/media/Z 340.png

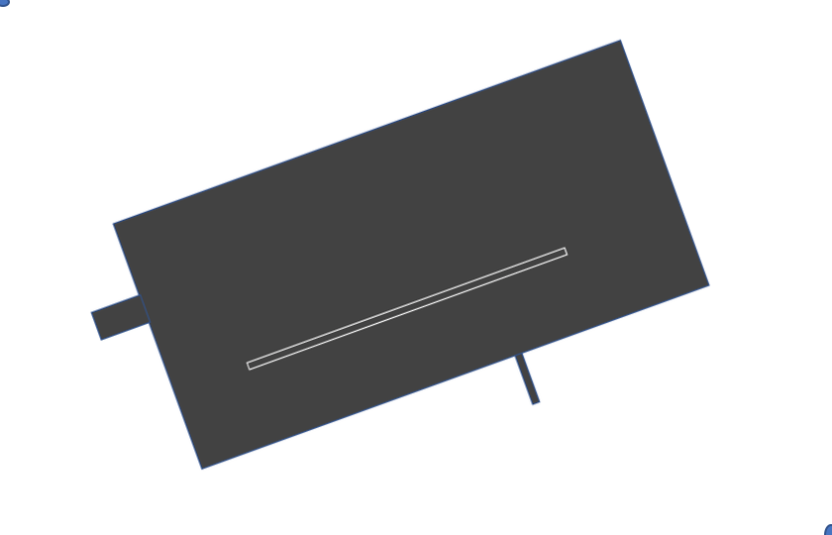
RSGS/media/Z 340.png
