jimwu6/Nocturne/RSGS/media/Z 350.png

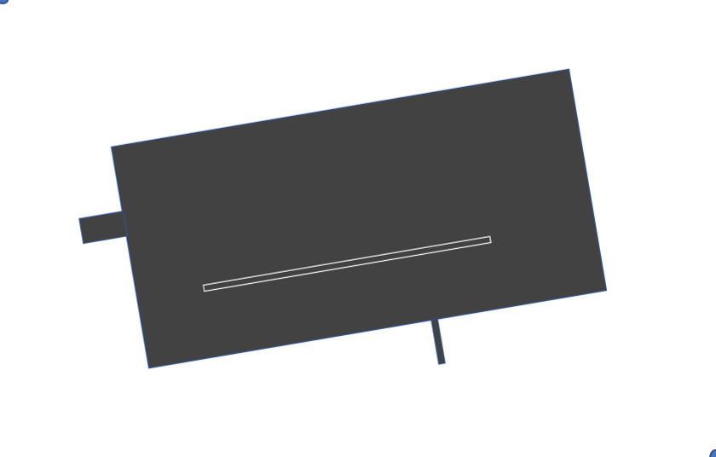
RSGS/media/Z 350.png
